zrs5532/mri_demo/references/ft231x-breakout-v11/5vPin.PNG

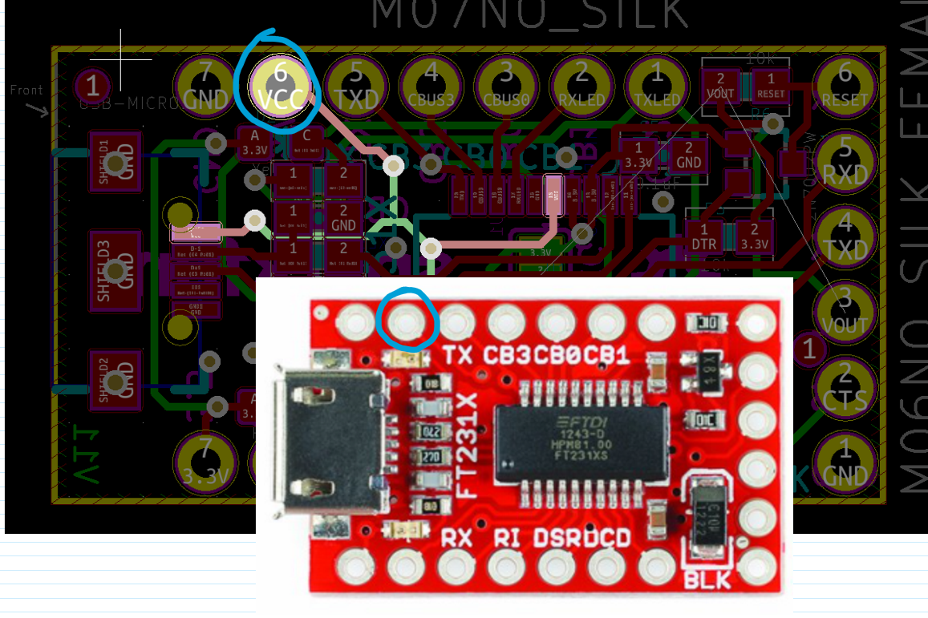
references/ft231x-breakout-v11/5vPin.PNG
