zrs5532/mri_demo/SensorDemoReport.docx

Lou Auto Robotics Research Institute:

Skin Sensor Demo

Daniel Nguyen

MRI Project

April 2021

# Appendix

Appendix A Introduction & Objectives
Appendix B Major Activities
  Appendix B.1 Hardware
  Appendix B.2 Software
Appendix C Conclusion

# Introduction & Objectives

The development of tactile robot skin is crucial for the next generation of robots to interact among human-centered environments. At the Louisville Automation & Robotics Research Institute (LARRI) under the MRI Project, researched have developed electronic skin using multiple sensors and components. The goal of the Demo Sensor Project is to provide a functional demonstration board to show and test the capability of the pickup and place machine, developed by Danming’s group (MRI Project).

The board can be used in two ways, with an off-the-shelf strain gauge sensor or with a strain gauge printed by the Optomec aerosol ink jet printer. The skin can sense changes in pressure using a lever hinge system and measuring a strain gauge using the Wheatstone half-bridge. The main disadvantage of this system is the narrow output range; thus, the output must be amplified adding overall noise.

# Major Activities

### Hardware

Measuring the resistive sensor uses a system including the Wheatstone half-bridge, an instrument amplifier (in-amp), and an analog-digital-convertor (ADC). Figure 1 illustrates an example of the Wheatstone half-bridge.

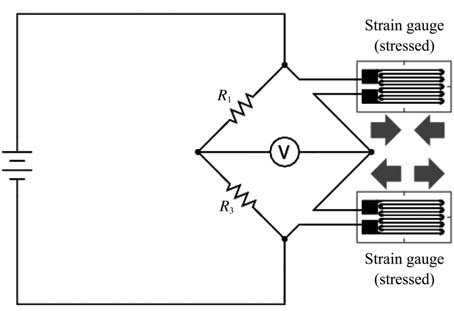
[picture p2: figure]
Wheatstone half-bridge circuit | Download Scientific Diagram

Figure 1: Wheatstone Bridge

The strain gauge device varies in resistance depending on the amount of strain. In the circuit for the Demo Sensor, the resistance with no strain on the device approximately 150 ohms. The strain gauges are put in opposite orientations so when the lever is pushed, one strain gauge gains resistance while the other decreases in resistance. The voltage between the two are inputted into the ADC which shows if the sensor is being pressed.

The material of the strain gauge is a fundamental parameter to the system. It is expressed mathematically as the gauge factor (GF). “Gauge factor is defined as the ratio of fractional change in electrical resistance to the fractional change in length (strain):” (NI Strain Gauge Measurement – A Tutorial)

, GF=(∆R/R)/(∆L/L)=(∆R/R)/ε#(1)

For the Skin Sensor Demo, a GF of 1 is used and a strain (ε) of 500*10^(-6) . After calculations, a ∆R is approximately +/- 0.075 ohms. This can be used in the next calculation to show the how accurate the DAC and ADC must be discussed later.

Figure 2 is a reference of the instrument amplifier.

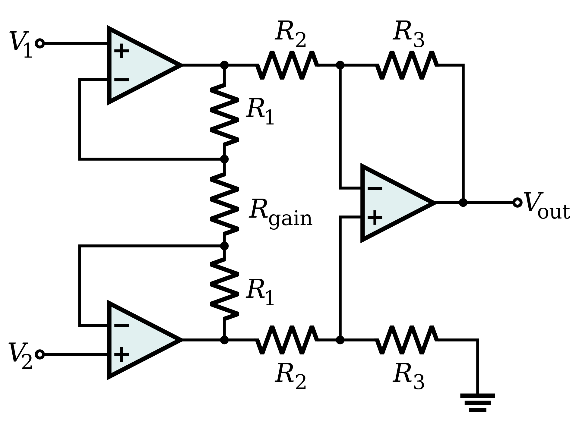
[picture p3: figure]
Instrumentation amplifier - Wikipedia

Figure 2: Instrument Amplifier

The base equation for an instrument amplifier is:

, V_(out) =Gain*(V_1 -V_2 ) + V_(ref) #(2)

Through calibration in the software and the DAC, V_1 is set to a constant value within a small range very close to V_2 . V_2 is connected to the sensor. Thus, any changes in the resistor results in a change in voltage in V_2 being amplified to V_(out) . The instrument amplifier is referenced to 1.5 volts. Using equation 2 calculates that a gain of approximately 2500 best fits the system. Gain is set to a high value because the resistance change of the sensor is small. Under brief testing, a gain of 200 is found to work the best.

Figure 3 shows a block diagram of the circuit.

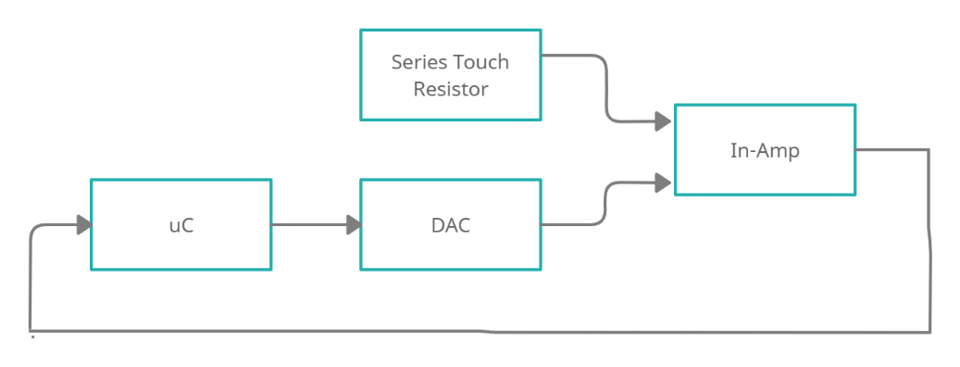
[picture p4: figure]

Figure 3: Block Diagram

As shown in figure 3, the voltage difference measured in the in-amp is the key in measuring the resistance change. The analog-to-digital converter (ADC) of the micro controller and the DAC are 12 bits. The two components are also referenced to 3 volts – GND because of its convenience. The REF19xx series chip is used to reference the voltage is a lower Vref is preferred.

The current design uses a dsPIC33EP32GP502 micro controller, the LTC1659 DAC, and the INA333 instrument amplifier. These components were picked based on how they complement each other as well as the accuracy. Another reason these components were picked is because of the SOIC package. Keep in mind the parts are placed on the PCB with spaced with a certain distance so the Pick-And-Place machine can assemble it with little issues. Because the project is also meant to test this machine, a MSOP8 packaged device is also placed on the board.

The current Micro-Controller Unit (MCU) is used because of its many features such as serial communication busses, flash memory size, and speed. The firmware only uses 6% of the micro’s data bytes and 30% of the micro’s program words.

The accuracy of the ADC and DAC are crucial for this board. The change min and max voltage that is inputted into the ADC is approximately 1.125mV. The step size for a 12-bit ADC and DAC referenced to 3 volts is approximately 0.7324mV. With a gain calculated previously, a 12-bit ADC and DAC are accurate enough for this application.

The LTC1659 DAC is used specifically because it has the same resolution as the micro controller. Because of this, no conversion is needed when sending adjusting the DAC after reading values from the 12-bit ADC of the micro controller during calibration. Figure 4 illustrates the internal structure of the DAC.

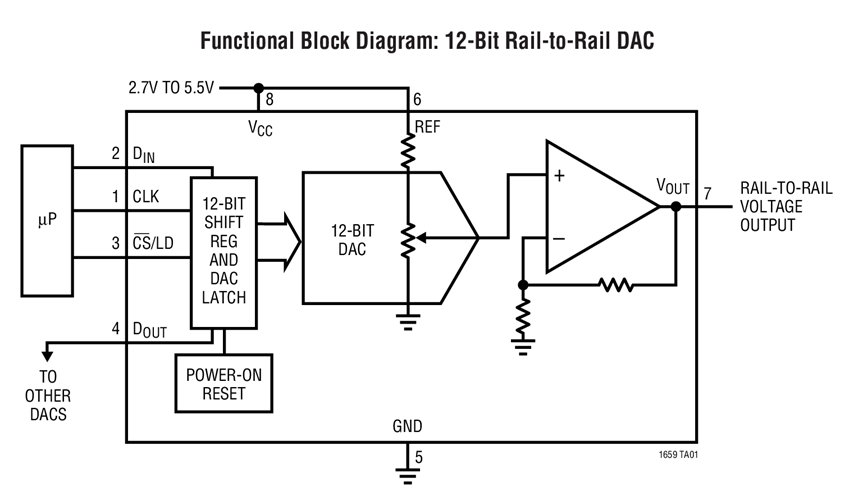
[picture p5: figure]
Functional Block Diagram: 12-Bit Rail-to-Rail DAC

Figure 4: LTC1659 Internal Structure

Because the resistance change of the touch resistor has a very small range, this paired with a less accurate in-amp did not work. For the first prototype, the In-Amp picked is the INA333. It is a rail-to-rail instrument amplifier and is rather accurate. Figure 5 illustrates the internal structure of the INA333.

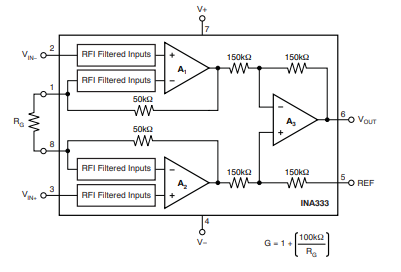
[picture p6: figure]

Figure 5: INA333 Internal Structure

Another small board is designed for the MCU to communicate with the computer. This includes the FT231X Breakout UART to USB. The programming board also allows for the PICkit 3 to connect to the main board.

The software used to design the schematic and PCB is KiCad 64bit for Windows OS version 5.1.9 because of its user-friendly interface and the simplicity of the project.

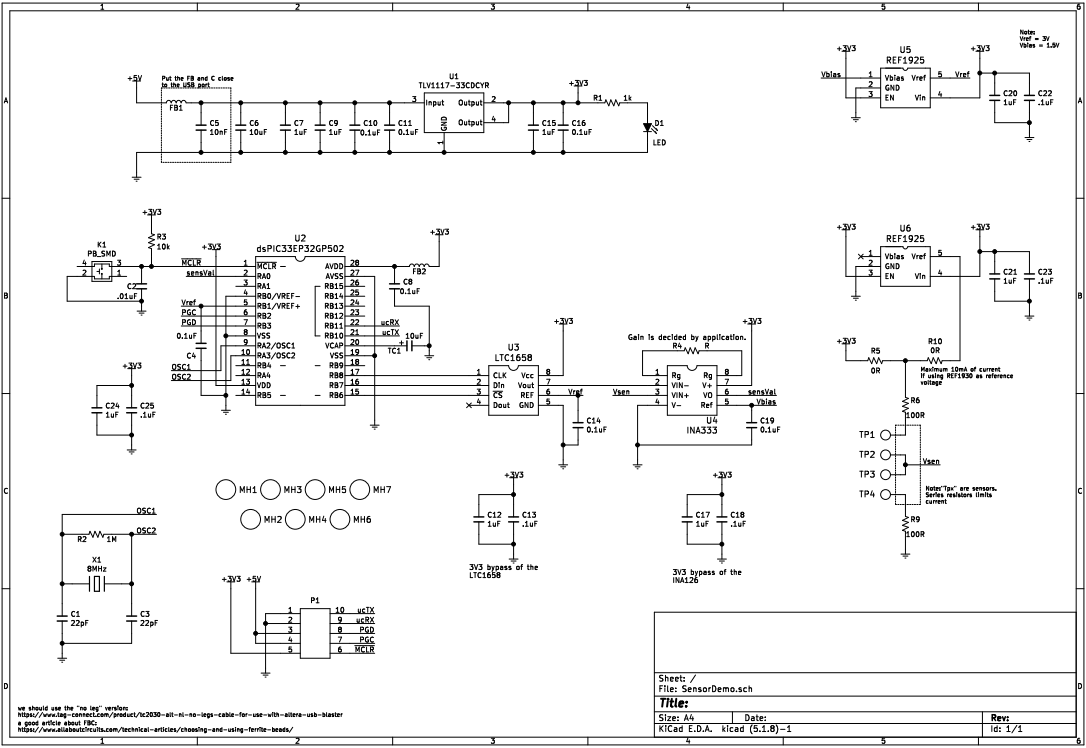
[picture p7: figure]

Figure 6: Schematic of Sensor Demo Board

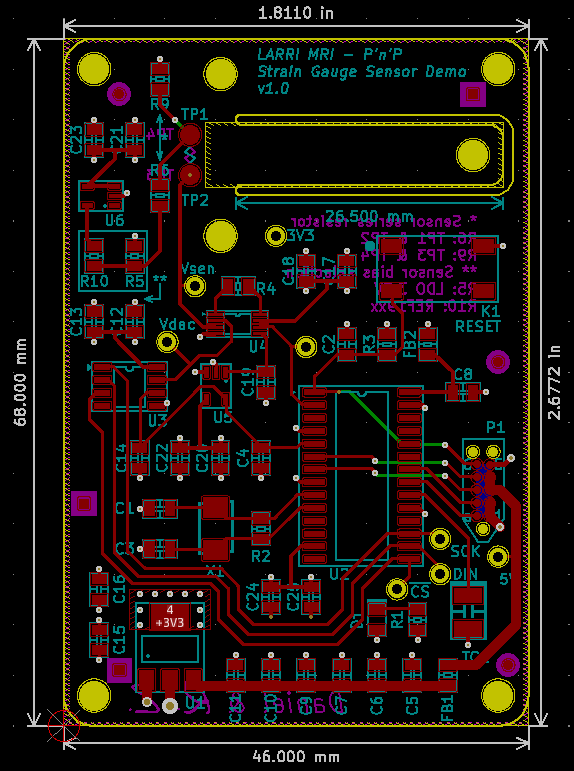
[picture p8: figure]

Figure 7: PCB Design of Sensor Demo Board

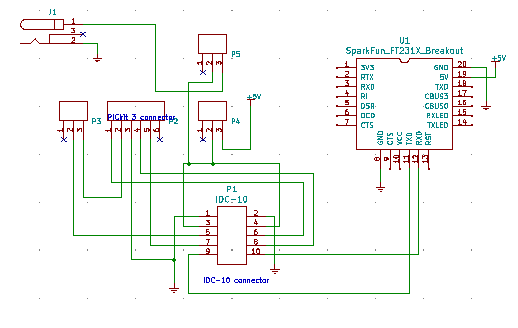
[picture p9: figure]

Figure 8: Schematic Design of Programming Board

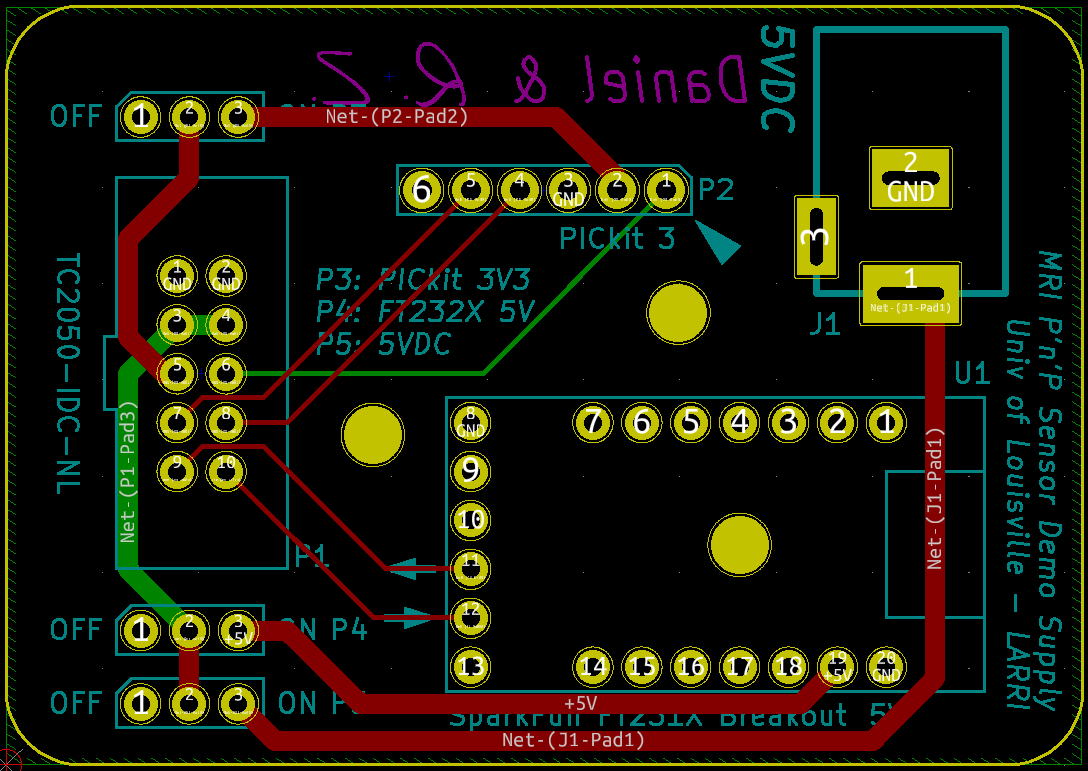
[picture p10: figure]

Figure 9: PCB Design of Programming Board

### Software

Two communication busses are used in the MCU. Those are SPI and UART. The MCU communicates with the DAC through the SPI Bus, and with a computer through the UART communication bus. At boot-up of the PCB, there is a delay for the voltages and board to settle. This is because if the strain gauge sensor is in an off position, the calibration will calibrate to the position that the sensor is in. The ADC reading needs to be stable for the calibration to be most accurate. After this, the software calibrates for the first time.

The software constantly checks the UART Receive register. If it receives a certain keystroke, the software will either recalibrate, stop reading the sensor value, or continue reading the sensor value. A snippet of the code is shown below:

cmd = UART1_RX_NB();

switch(cmd) {

case '1': //Calibrates & reads sensor

runCalibrate = true;

calibrate();

dacIncrement = 200;

runSensor = true;

break;

case '2': //Continue sensor reading

runSensor = true;

break;

case '3': //Stop sensor reading

runSensor = false;

break;

}

The calibration algorithm went through multiple test phases. During the first prototype, a step algorithm was put in place. This will increase or decrease the value the DAC outputs by a small margin to match the idle voltage of the touch resistor. Because the resolution of the ADC and DAC are quite large, the step algorithm was considered too slow and the implementation of a PID controller was tested.

The PID controller was not as fast in practice as in theory because the referenced voltage of the ADC is too small. As mentioned earlier, all the components are referenced from 3 Volts to Ground. If the DAC is too large or small, the ADC reading will read the output as either 0 or the max resolution, 4095 for a 12-bit ADC.

The final algorithm put in place is like a Bang controller. Initially, the DAC will swing a large value until it crosses the setpoint range. Once it crosses the setpoint range, the constant value that the DAC swings is decreased by 50% until it crosses the setpoint again. Through testing, this algorithm has been proven too be significantly faster. A snippet of the code structure is shown below:

while (runCalibrate) {

ADC1Val(); //Updates sensVal (ADC reading)

//if the sensor reading is above/below setpoint, change DAC output

if(sensVal <= lowBound) {

dacVal -= dacIncrement;

flag = 0; //DAC IS BELOW ADC READING

} else if (sensVal >= upperBound) {

dacVal += dacIncrement;

flag = 1; //DAC IS ABOVE ADC READING

}

SPI_transfer16(dacVal);

ADC1Val();

//Checks if ADC reading is within range

if((sensVal >= lowBound) && (sensVal <= upperBound)) {

runCalibrate = false; // BREAK WHILE LOOP

} else if (dacIncrement == 0) {

dacIncrement += 1;

}

//Checks if DAC crossed the setpoint range. If so, decrease the increment.

if((sensVal <= lowBound) && (flag == 1)) {

dacIncrement = (uint16_t)(dacIncrement / 2);

} else if ((sensVal >= upperBound) && (flag == 0)) {

dacIncrement = (uint16_t)(dacIncrement / 2);

}

ADC1Val();

printf("Calibrating... %u\n\r", sensVal);

}

}

# Conclusion

This project serves multiple purposes such as a tactile sensor that can be used as electronic robotic skin and a board used to test the Pick-And-Place machine at the LARRI lab. The PCB is designed with the components spaced out to test the accuracy of the new machine. This Sensor Board Demo also contributes to other areas in the MRI Project such as the Octo-Can through the software such as the calibration algorithm.

Works Cited

National Instruments Corporation. Strain Gauge Measurement – a Tutorial What Is Strain? 1998. http://elektron.pol.lublin.pl/elekp/ap_notes/NI_AN078_Strain_Gauge_Meas.pdf
