zrs5532/mri_demo/circuit_board/BOM.xlsx

Component | Description | Link | Quantity
C1, C3 | 22pF | https://www.mouser.com/ProductDetail/KEMET/C0805C220K3HACTU?qs=W0yvOO0ixfH4YTEs6bNX1Q%3D%3D | 100
C2, C5, C6 | 0.01uF | https://www.mouser.com/ProductDetail/AVX/08051C103KAT2A?qs=KWx4lwXkSG0FvSLLLRI%252BHw%3D%3D | 100
C4, C8, C10, C11, C13, C14, C16, C18, C19, C22, C23, C25 | 0.1uF | https://www.mouser.com/ProductDetail/AVX/08055C104KAT2A | 100
C7, C9, C12, C15, C17, C20, C21, C24 | 1uF | https://www.mouser.com/ProductDetail/Samsung-Electro-Mechanics/CL21B105KOFNNNG | 100
FB1, FB2 | 12.3071 nano Ohm | https://www.mouser.com/ProductDetail/Fair-Rite/2508051027Y1?qs=paL1wOLBYNd1w0Ok9jKq0w%3D%3D | 100
K1 | Push Button | https://www.mouser.com/ProductDetail/E-Switch/LL3301NF065QG/?qs=QtyuwXswaQiWhwgY68YTTw%3D%3D | 25
R1 | 1k Ohm | https://www.mouser.com/ProductDetail/Vishay-Dale/CRCW08051K00FKEAC | 100
R2 | 1M Ohm | https://www.mouser.com/ProductDetail/Vishay-Dale/CRCW08051M00FKEAC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 | 100
R3 | 10k Ohm | https://www.mouser.com/ProductDetail/Bourns/CR0805-FX-1003ELF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 | 100
R6, R9 | 100 Ohm | https://www.mouser.com/ProductDetail/Vishay-Dale/CRCW0805100RFKEAC | 100
TC1 | 10uF | https://www.mouser.com/ProductDetail/AVX/TAJA106K010RNJV?qs=q%252BHV0zBR8MhA8vzi7uQCHA%3D%3D | 20
U1 | LDO - TLV1117-33CDCYR | https://www.mouser.com/ProductDetail/STMicroelectronics/LDL1117S33R?qs=AQlKX63v8Rt9Bf6AWSrbFg%3D%3D | 20
U2 | dsPIC33EP32GP502 | https://www.mouser.com/ProductDetail/Microchip-Technology/dsPIC33EP32GP502-E-SO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 | 5
U3 | DAC - LTC1659 | https://www.mouser.com/ProductDetail/Analog-Devices/LTC1659CS8PBF?qs=hVkxg5c3xu8qJBo8OQTZhA%3D%3D | 5
 | LTC 1655L | https://www.mouser.com/ProductDetail/Analog-Devices/LTC1655LCS8PBF?qs=hVkxg5c3xu8u%2FxCpkCR9Ow%3D%3D | 3
 | LED | https://www.mouser.com/ProductDetail/Kingbright/APT2012SRCPRV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 | 10
 | 0R | https://www.mouser.com/ProductDetail/Yageo/RC0805JR-070RL | 100
 | IDC | https://www.mouser.com/ProductDetail/Wurth-Elektronik/61201021621 | 5
 | uart bridge | https://www.mouser.com/ProductDetail/SparkFun/BOB-13263?qs=wwacUt%252BV97sxFBQnsYRtRA%3D%3D | 3
 | tag-cable | https://www.tag-connect.com/product/tc2050-idc-nl-10-pin-no-legs-cable-with-ribbon-connector | 1
stunts | SOIC8 | https://www.mouser.com/ProductDetail/STMicroelectronics/LM358DT | 10
 | MSOP8 | https://www.mouser.com/ProductDetail/NJR/NJM2904CARB1-TE1 | 10
 | SOIC28 | https://www.mouser.com/ProductDetail/Microchip-Technology/PIC16F57-I-SO?qs=Sez7gRs8XSVGQsbqhsgs1Q%3D%3D | 10
 | SOT23-5 | https://www.mouser.com/ProductDetail/Microchip-Technology-Micrel/MIC5504-33YM5-TR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 | 10
 | SOT223 | https://www.mouser.com/ProductDetail/Nexperia/PMT560ENEAX?qs=gH1BdSMZm8VarNhHxchsUg%3D%3D | 10
