zrs5532/mri_demo/circuit_board/SensorDemo/SensorDemo.kicad_pcb

## KiCad design circuit_board/SensorDemo/SensorDemo.kicad_pcb (2021-08-11)

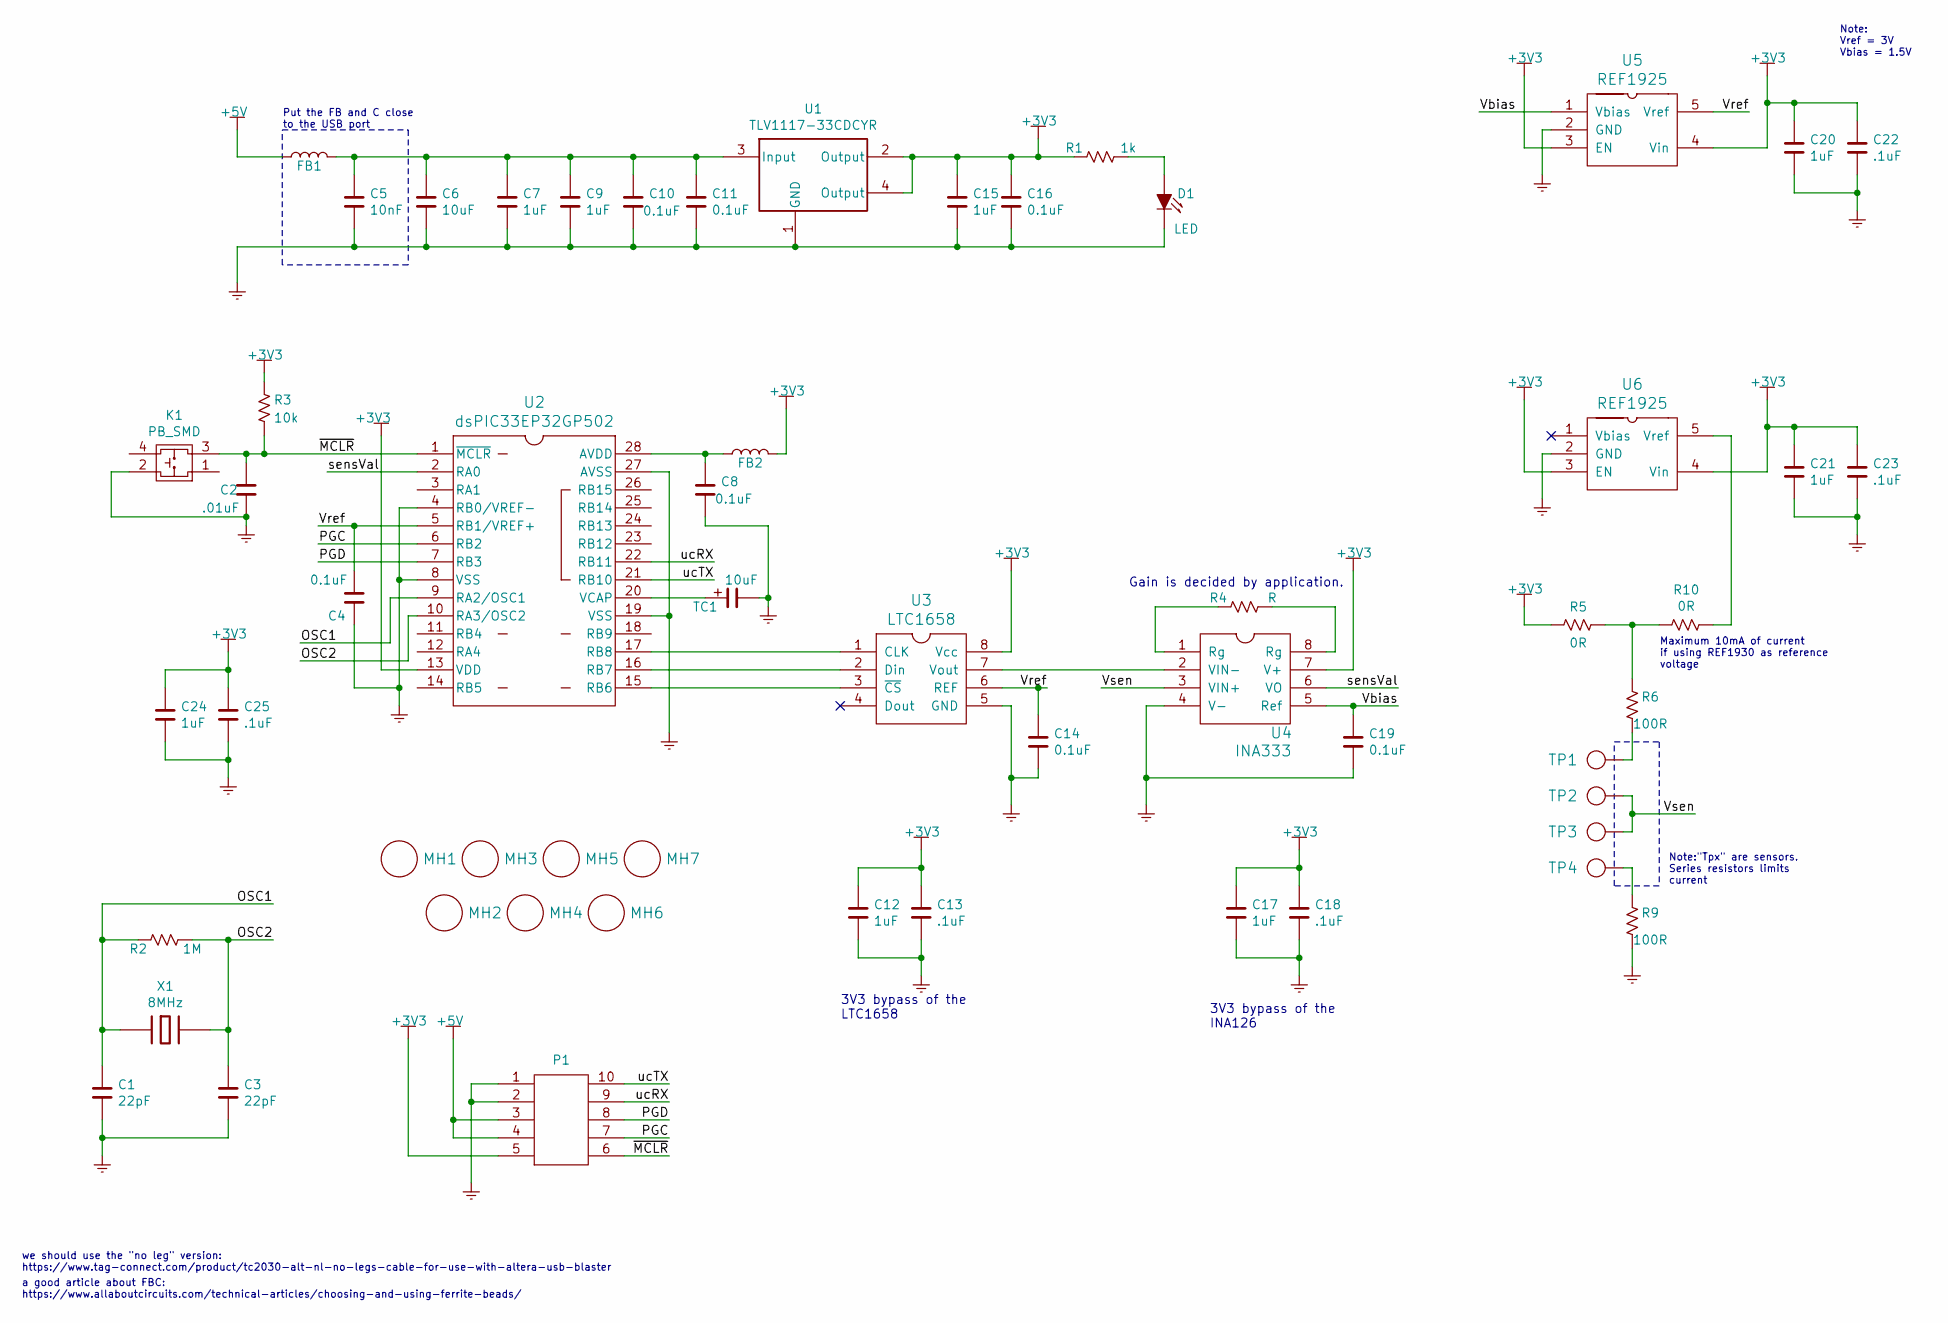
[picture p11: schematic SensorDemo.sch]

Parts:
C1, C3: 22pF; C0805
C2: .01uF; C0805
C4, C8, C10, C11, C14, C16, C19: 0.1uF; C0805
C5: 10nF; C0805
C6: 10uF; C0805
C7, C9, C12, C15, C17, C20, C21, C24: 1uF; C0805
C13, C18, C22, C23, C25: .1uF; C0805
D1: LED; LED0805
FB1, FB2: 12.3071 nano ohm; R0805
K1: PB_SMD; Key_SMD
MH1, MH2, MH3, MH4, MH5, MH6, MH7: MH; MH_3MM
P1: TC2050_IDC_NL; TC2050
R1: 1k; R0805
R2: 1M; R0805
R3: 10k; R0805
R4: R; R0805
R5, R10: 0R; R0805
R6, R9: 100R; R0805
TC1: 10uF; C1210
TP1, TP2, TP3, TP4: TP; TP_SMD_2MM
U1: TLV1117-33CDCYR; SOT-223
U2: dsPIC33EP32GP502; SOIC-28
U3: LTC1658; SOIC-8
U4: INA333; MSOP-8
U5, U6: REF1925; SOT-23-5
X1: 8MHz; CRYSTAL_ABM3-8.000MHz-D2Y-T

Connections:
+3V3: C12.1, C13.1, C15.1, C16.1, C17.1, C18.1, C20.1, C21.1, C22.1, C23.1, C24.1, C25.1, FB2.2, P1.5, R1.1, R3.1, R5.1, U1.2 (Output), U1.4 (Output), U2.13 (VDD), U3.8 (Vcc), U4.7 (V+), U5.3 (EN), U5.4 (Vin), U6.3 (EN), U6.4 (Vin); also elsewhere on the board
+5V: FB1.1, P1.3, P1.4; also elsewhere on the board
/OSC1: C1.1, R2.1, U2.9 (RA2/OSC1), X1.1
/OSC2: C3.1, R2.2, U2.10 (RA3/OSC2), X1.2
/PGC: P1.7, U2.6 (RB2)
/PGD: P1.8, U2.7 (RB3)
/Vbias: C19.1, U4.5 (Ref), U5.1 (Vbias)
/Vref: C4.1, C14.1, U2.5 (RB1/VREF+), U3.6 (REF), U5.5 (Vref)
/Vsen: TP2.1, TP3.1, U4.3 (VIN+); also elsewhere on the board
/sensVal: U2.2 (RA0), U4.6 (VO); also elsewhere on the board
/ucRX: P1.9, U2.22 (RB11)
/ucTX: P1.10, U2.21 (RB10)
/~MCLR: C2.1, K1.3, P1.6, R3.2, U2.1 (~MCLR)
GND: C1.2, C2.2, C3.2, C4.2, C5.2, C6.2, C7.2, C8.2, C9.2, C10.2, C11.2, C12.2, C13.2, C14.2, C15.2, C16.2, C17.2, C18.2, C19.2, C20.2, C21.2, C22.2, C23.2, C24.2, C25.2, D1.2 (K), K1.2, P1.1, P1.2, R9.2, TC1.2, U1.1 (GND), U2.4 (RB0/VREF-), U2.8 (VSS), U2.19 (VSS), U2.27 (AVSS), U3.5 (GND), U4.4 (V-), U5.2 (GND), U6.2 (GND)
unnamed: C8.1, FB2.1, U2.28 (AVDD)
unnamed: C5.1, C6.1, C7.1, C9.1, C10.1, C11.1, FB1.2, U1.3 (Input)
unnamed: D1.1 (A), R1.2
unnamed: R4.1, U4.1 (Rg)
unnamed: R4.2, U4.8 (Rg)
unnamed: R6.2, TP1.1
unnamed: R9.1, TP4.1
unnamed: R5.2, R6.1, R10.1
unnamed: R10.2, U6.5 (Vref)
unnamed: TC1.1, U2.20 (VCAP)
unnamed: U2.15 (RB6), U3.3 (~CS)
unnamed 25: U2.16 (RB7), U3.2 (Din); also elsewhere on the board
unnamed 26: U2.17 (RB8), U3.1 (CLK); also elsewhere on the board
unnamed 27: U3.7 (Vout), U4.2 (VIN-); also elsewhere on the board

Notes on the sheet:
Note: Vref = 3V Vbias = 1.5V
Put the FB and C close to the USB port
a good article about FBC: https://www.allaboutcircuits.com/technical-articles/choosing-and-using-ferrite-beads/
Gain is decided by application.
3V3 bypass of the LTC1658
3V3 bypass of the INA126
Maximum 10mA of current if using REF1930 as reference voltage
Note:"Tpx" are sensors. Series resistors limits current
we should use the "no leg" version: https://www.tag-connect.com/product/tc2030-alt-nl-no-legs-cable-for-use-with-altera-usb-blaster

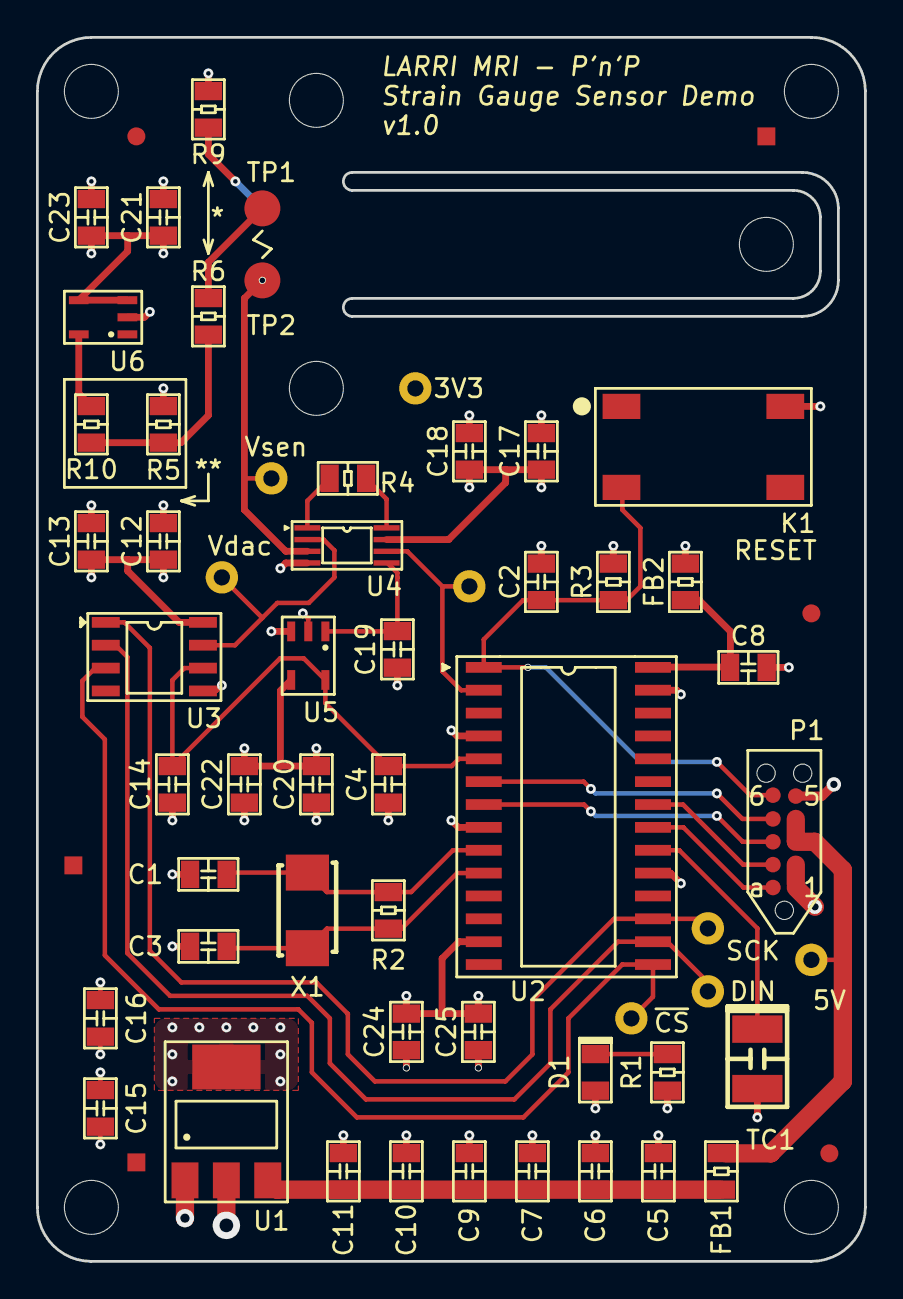
[picture p12: board SensorDemo.kicad_pcb from above]

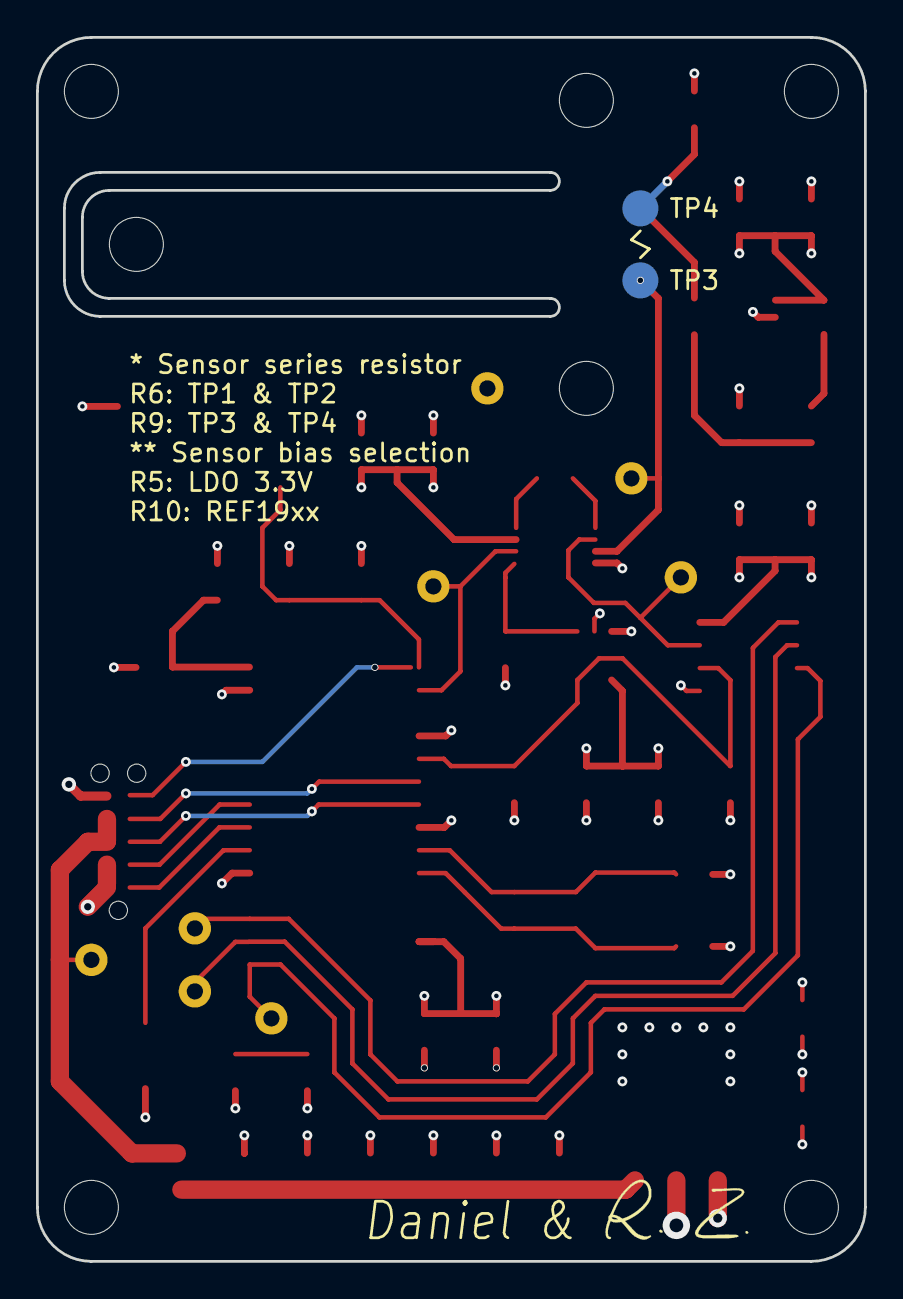
[picture p13: board SensorDemo.kicad_pcb from below]

Board: 4 copper layers, 46.0 x 68.0 mm, 70 parts (2 on the bottom side), 28 nets.

Other parts of the board:
3V3, 5V: TP_TH
DIN: TP_TH
FD: Val**; FD_1MM_CR
FD#2, FD#3, FD#5: Val**; FD_1MM_SQ
FD#4, FD#6: Val**; FD_1MM_CR
SCK: TP_TH
Vdac: TP_TH
Vsen: TP_TH
sensVal: TP_TH

Their connections:
+3V3: 3V3.1; also elsewhere on the board
+5V: 5V.1; also elsewhere on the board
/Vsen: Vsen.1; also elsewhere on the board
/sensVal: sensVal.1; also elsewhere on the board
unnamed 25: DIN.1; also elsewhere on the board
unnamed 26: SCK.1; also elsewhere on the board
unnamed 27: Vdac.1; also elsewhere on the board
