zrs5532/mri_demo/circuit_board/ProgramBoard/ProgramBoard.kicad_pcb

## KiCad design circuit_board/ProgramBoard/ProgramBoard.kicad_pcb (2021-03-16)

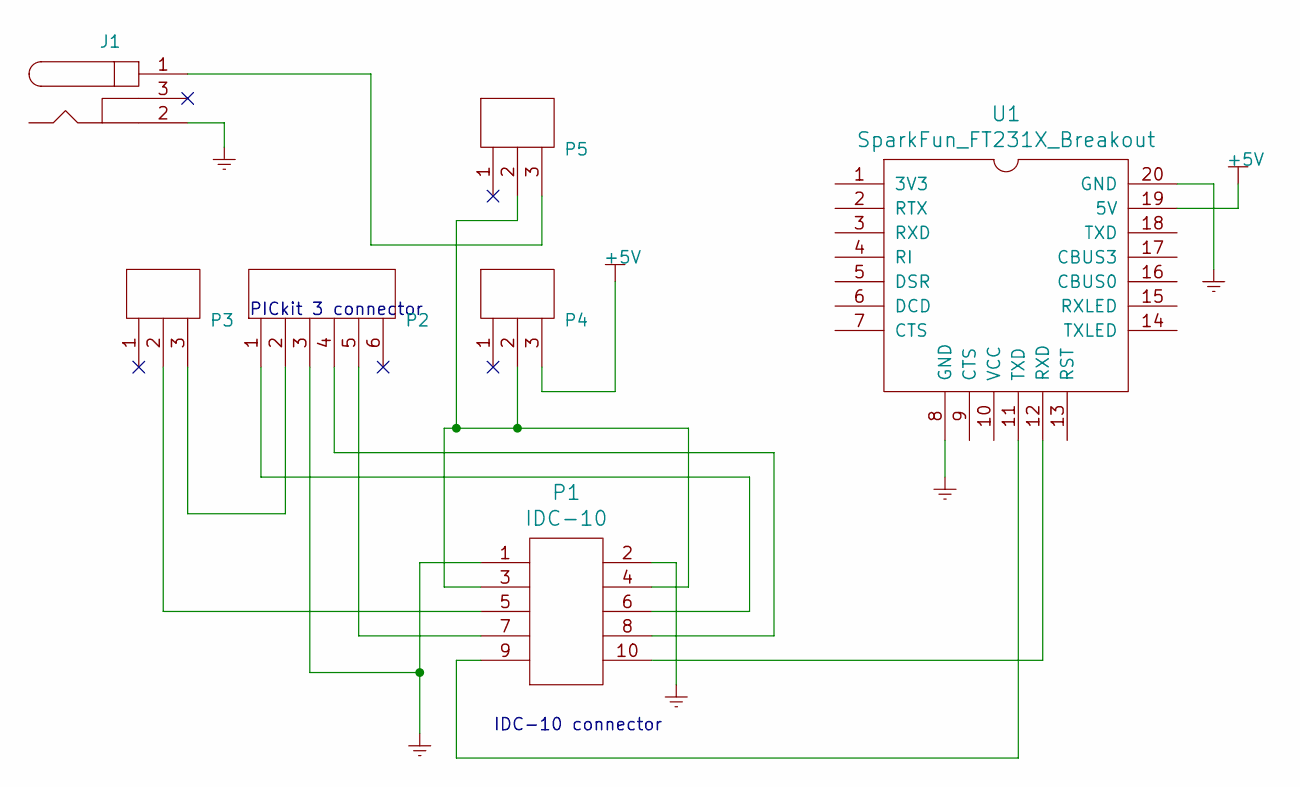
[picture p14: schematic ProgramBoard.sch]

Parts:
J1: BARREL_JACK
P1: IDC-10; IDC_10
P2: HEADER_6
P3, P4, P5: HEADER_3
U1: SparkFun_FT231X_Breakout

Connections:
+5V: P4.3, U1.19 (5V)
GND: J1.2, P1.1, P1.2, P2.3, U1.8 (GND), U1.20 (GND)
unnamed: J1.1, P5.3
unnamed: P1.3, P1.4, P4.2, P5.2
unnamed: P1.5, P3.2
unnamed: P1.6, P2.1
unnamed: P1.7, P2.5
unnamed: P1.8, P2.4
unnamed: P1.9, U1.11 (TXD)
unnamed: P1.10, U1.12 (RXD)
unnamed: P2.2, P3.3

Notes on the sheet:
PICkit 3 connector
IDC-10 connector

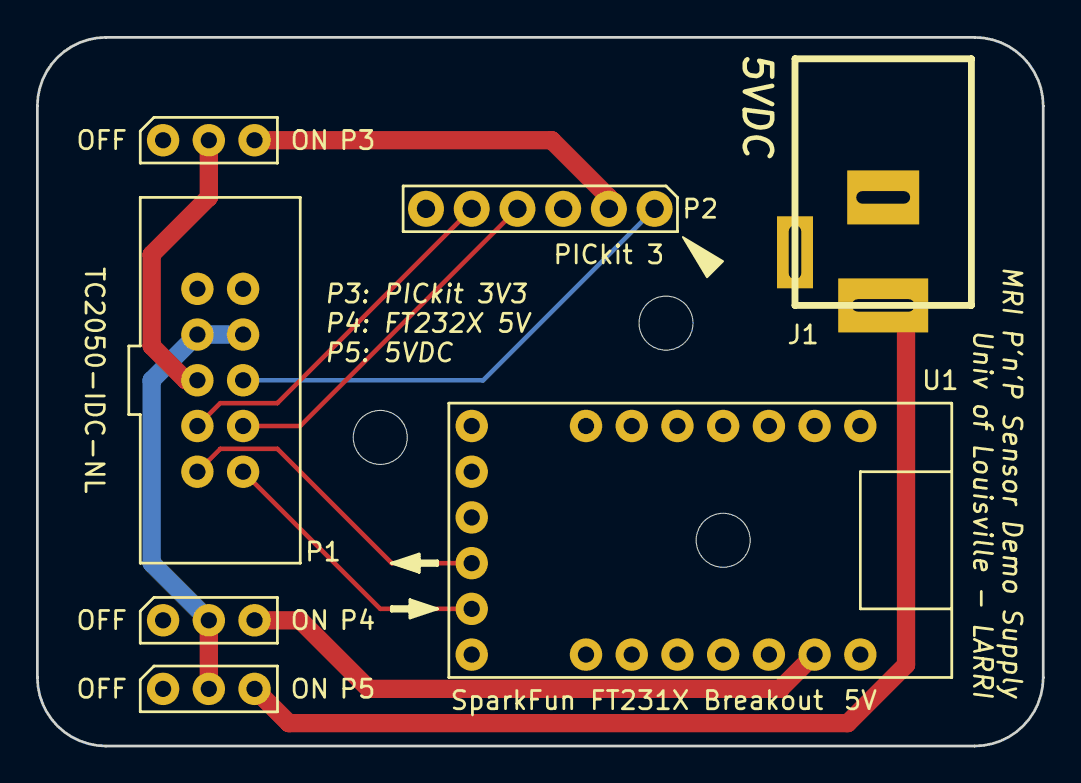
[picture p15: board ProgramBoard.kicad_pcb from above]

Board: 2 copper layers, 55.9 x 39.4 mm, 10 parts (0 on the bottom side), 11 nets.

Other parts of the board:
MH3, MH3#2, MH3#3: MH; MH_3MM
