zrs5532/mri_demo/references/ft231x-breakout-v11/ft231x-breakout-v11.brd

## EAGLE design references/ft231x-breakout-v11/ft231x-breakout-v11.brd (2021-02-16)

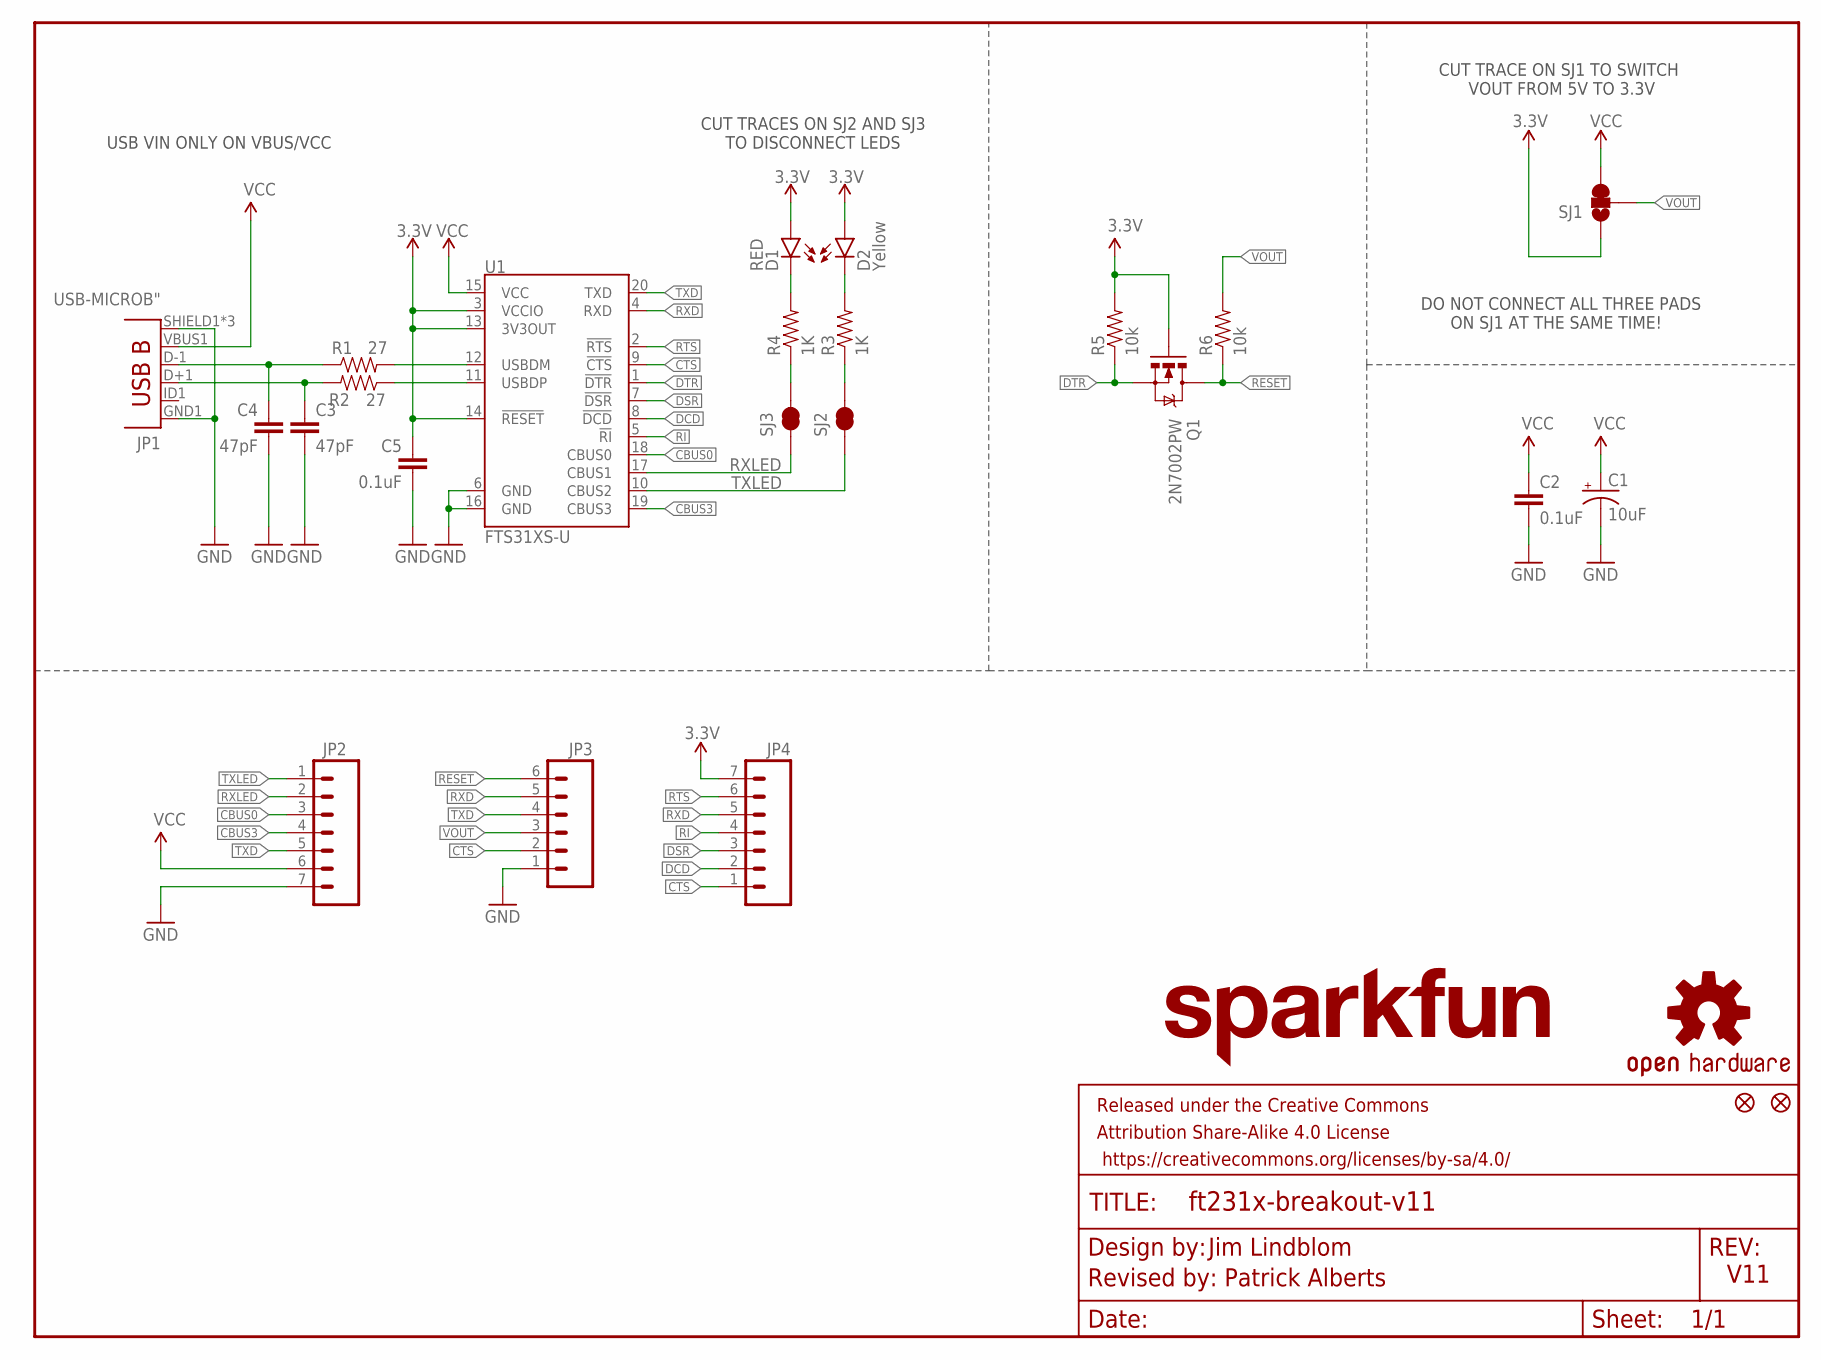
[picture p16: schematic ft231x-breakout-v11.sch]

Parts:
C1: 10uF; EIA3216
C2, C5: 0.1uF; 0603-CAP
C3, C4: 47pF; 0603-CAP
D1: RED; LED-0603
D2: Yellow; LED-0603
FRAME1: FRAME-LETTER; CREATIVE_COMMONS
JP1: USB-MICROB"; USB-B-MICRO-SMD_V03
JP2, JP4: M07NO_SILK; 1X07_NO_SILK
JP3: M06NO_SILK_FEMALE_PTH; 1X06_NO_SILK
JP5, JP6: FIDUCIAL1X2; FIDUCIAL-1X2
LOGO1: SFE_LOGO_NAME.1_INCH; SFE_LOGO_NAME_.1
Q1: 2N7002PW; SOT323
R1, R2: 27; 0603-RES
R3, R4: 1K; 0603-RES
R5, R6: 10k; 0603-RES@1
SJ1: SOLDERJUMPER_2WAYS; SJ_3
SJ2: TXLED; SJ_2S-TRACE
SJ3: RXLED; PAD-JUMPER-2-NC_BY_TRACE_YES_SILK
U1: FTS31XS-U; SSOP20_L
U$1: OSHW-LOGOS; OSHW-LOGO-S

Connections:
3.3V: C5.1, D1.A, D2.A, JP4.7, Q1.1 (G), R5.2, SJ1.1, U1.3 (VCCIO), U1.13 (3V3OUT), U1.14 (!RESET)
CBUS0: JP2.3, U1.18 (CBUS0)
CBUS3: JP2.4, U1.19 (CBUS3)
CTS: JP3.2, JP4.1, U1.9 (!CTS)
DCD: JP4.2, U1.8 (!DCD)
DSR: JP4.3, U1.7 (!DSR)
DTR: Q1.2 (S), R5.1, U1.1 (!DTR)
GND: C1.C (-), C2.2, C3.2, C4.2, C5.2, JP1.GND1 (GND), JP1.SHIELD1 (SHIELD), JP1.SHIELD2 (SHIELD), JP1.SHIELD3 (SHIELD), JP2.7, JP3.1, U1.6 (GND), U1.16 (GND)
unnamed: R1.2, U1.12 (USBDM)
unnamed: R2.1, U1.11 (USBDP)
unnamed: C3.1, JP1.D+1 (D+), R2.2
unnamed: C4.1, JP1.D-1 (D-), R1.1
unnamed: D2.C, R3.2
unnamed: D1.C, R4.2
unnamed: R3.1, SJ2.2
unnamed: R4.1, SJ3.2
RESET: JP3.6, Q1.3 (D), R6.1
RI: JP4.4, U1.5 (!RI)
RTS: JP4.6, U1.2 (!RTS)
RXD: JP3.5, JP4.5, U1.4 (RXD)
RXLED: JP2.2, SJ3.1, U1.17 (CBUS1)
TXD: JP2.5, JP3.4, U1.20 (TXD)
TXLED: JP2.1, SJ2.1, U1.10 (CBUS2)
VCC: C1.A (+), C2.1, JP1.VBUS1 (VBUS), JP2.6, SJ1.3, U1.15 (VCC)
VOUT: JP3.3, R6.2, SJ1.2

Notes on the sheet:
V11
Jim Lindblom
Revised by: Patrick Alberts
USB VIN ONLY ON VBUS/VCC
CUT TRACES ON SJ2 AND SJ3 TO DISCONNECT LEDS
CUT TRACE ON SJ1 TO SWITCH VOUT FROM 5V TO 3.3V
DO NOT CONNECT ALL THREE PADS ON SJ1 AT THE SAME TIME!

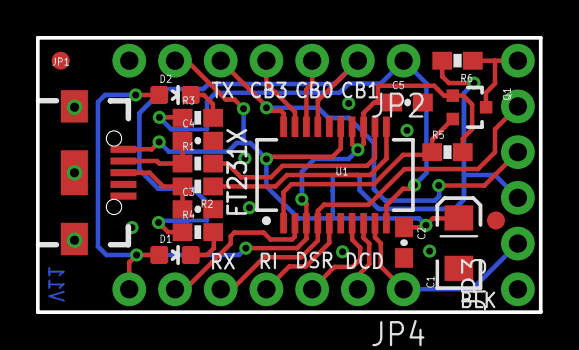
[picture p17: board ft231x-breakout-v11.brd from above]

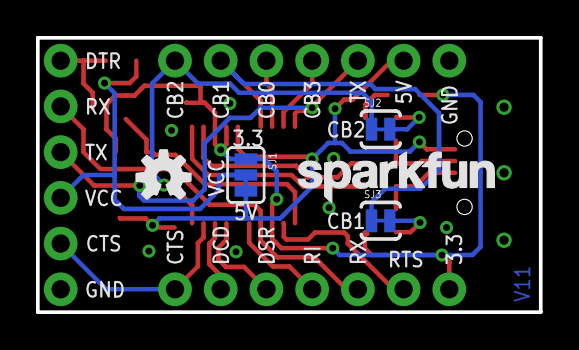
[picture p18: board ft231x-breakout-v11.brd from below]

Board: 2 copper layers, 27.9 x 15.2 mm, 27 parts (5 on the bottom side), 25 nets.
