zrs5532/mri_demo/firmware/SensorDemo.X/mcc_generated_files/pin_manager.h

/**
  PIN MANAGER Generated Driver File

  @Company:
    Microchip Technology Inc.

  @File Name:
    pin_manager.h

  @Summary:
    This is the generated manager file for the PIC24 / dsPIC33 / PIC32MM MCUs device.  This manager
    configures the pins direction, initial state, analog setting.
    The peripheral pin select, PPS, configuration is also handled by this manager.

  @Description:
    This source file provides implementations for PIN MANAGER.
    Generation Information :
        Product Revision  :  PIC24 / dsPIC33 / PIC32MM MCUs - 1.170.0
        Device            :  dsPIC33EP32GP502
    The generated drivers are tested against the following:
        Compiler          :  XC16 v1.61
        MPLAB 	          :  MPLAB X v5.45
*/

/*
    (c) 2020 Microchip Technology Inc. and its subsidiaries. You may use this
    software and any derivatives exclusively with Microchip products.

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
    IN NO EVENT WILL MICROCHIP BE LIABLE FOR ANY INDIRECT, SPECIAL, PUNITIVE,
    INCIDENTAL OR CONSEQUENTIAL LOSS, DAMAGE, COST OR EXPENSE OF ANY KIND
    WHATSOEVER RELATED TO THE SOFTWARE, HOWEVER CAUSED, EVEN IF MICROCHIP HAS
    BEEN ADVISED OF THE POSSIBILITY OR THE DAMAGES ARE FORESEEABLE. TO THE
    FULLEST EXTENT ALLOWED BY LAW, MICROCHIP'S TOTAL LIABILITY ON ALL CLAIMS IN
    ANY WAY RELATED TO THIS SOFTWARE WILL NOT EXCEED THE AMOUNT OF FEES, IF ANY,
    THAT YOU HAVE PAID DIRECTLY TO MICROCHIP FOR THIS SOFTWARE.

    MICROCHIP PROVIDES THIS SOFTWARE CONDITIONALLY UPON YOUR ACCEPTANCE OF THESE
    TERMS.
*/

#ifndef _PIN_MANAGER_H
#define _PIN_MANAGER_H
/**
    Section: Includes
*/
#include <xc.h>

/**
    Section: Device Pin Macros
*/
/**
  @Summary
    Sets the GPIO pin, RA0, high using LATA0.

  @Description
    Sets the GPIO pin, RA0, high using LATA0.

  @Preconditions
    The RA0 must be set to an output.

  @Returns
    None.

  @Param
    None.

  @Example
    <code>
    // Set RA0 high (1)
    channel_AN0_SetHigh();
    </code>

*/
#define channel_AN0_SetHigh()          (_LATA0 = 1)
/**
  @Summary
    Sets the GPIO pin, RA0, low using LATA0.

  @Description
    Sets the GPIO pin, RA0, low using LATA0.

  @Preconditions
    The RA0 must be set to an output.

  @Returns
    None.

  @Param
    None.

  @Example
    <code>
    // Set RA0 low (0)
    channel_AN0_SetLow();
    </code>

*/
#define channel_AN0_SetLow()           (_LATA0 = 0)
/**
  @Summary
    Toggles the GPIO pin, RA0, using LATA0.

  @Description
    Toggles the GPIO pin, RA0, using LATA0.

  @Preconditions
    The RA0 must be set to an output.

  @Returns
    None.

  @Param
    None.

  @Example
    <code>
    // Toggle RA0
    channel_AN0_Toggle();
    </code>

*/
#define channel_AN0_Toggle()           (_LATA0 ^= 1)
/**
  @Summary
    Reads the value of the GPIO pin, RA0.

  @Description
    Reads the value of the GPIO pin, RA0.

  @Preconditions
    None.

  @Returns
    None.

  @Param
    None.

  @Example
    <code>
    uint16_t portValue;

    // Read RA0
    postValue = channel_AN0_GetValue();
    </code>

*/
#define channel_AN0_GetValue()         _RA0
/**
  @Summary
    Configures the GPIO pin, RA0, as an input.

  @Description
    Configures the GPIO pin, RA0, as an input.

  @Preconditions
    None.

  @Returns
    None.

  @Param
    None.

  @Example
    <code>
    // Sets the RA0 as an input
    channel_AN0_SetDigitalInput();
    </code>

*/
#define channel_AN0_SetDigitalInput()  (_TRISA0 = 1)
/**
  @Summary
    Configures the GPIO pin, RA0, as an output.

  @Description
    Configures the GPIO pin, RA0, as an output.

  @Preconditions
    None.

  @Returns
    None.

  @Param
    None.

  @Example
    <code>
    // Sets the RA0 as an output
    channel_AN0_SetDigitalOutput();
    </code>

*/
#define channel_AN0_SetDigitalOutput() (_TRISA0 = 0)
/**
  @Summary
    Sets the GPIO pin, RB6, high using LATB6.

  @Description
    Sets the GPIO pin, RB6, high using LATB6.

  @Preconditions
    The RB6 must be set to an output.

  @Returns
    None.

  @Param
    None.

  @Example
    <code>
    // Set RB6 high (1)
    CS1_SetHigh();
    </code>

*/
#define CS1_SetHigh()          (_LATB6 = 1)
/**
  @Summary
    Sets the GPIO pin, RB6, low using LATB6.

  @Description
    Sets the GPIO pin, RB6, low using LATB6.

  @Preconditions
    The RB6 must be set to an output.

  @Returns
    None.

  @Param
    None.

  @Example
    <code>
    // Set RB6 low (0)
    CS1_SetLow();
    </code>

*/
#define CS1_SetLow()           (_LATB6 = 0)
/**
  @Summary
    Toggles the GPIO pin, RB6, using LATB6.

  @Description
    Toggles the GPIO pin, RB6, using LATB6.

  @Preconditions
    The RB6 must be set to an output.

  @Returns
    None.

  @Param
    None.

  @Example
    <code>
    // Toggle RB6
    CS1_Toggle();
    </code>

*/
#define CS1_Toggle()           (_LATB6 ^= 1)
/**
  @Summary
    Reads the value of the GPIO pin, RB6.

  @Description
    Reads the value of the GPIO pin, RB6.

  @Preconditions
    None.

  @Returns
    None.

  @Param
    None.

  @Example
    <code>
    uint16_t portValue;

    // Read RB6
    postValue = CS1_GetValue();
    </code>

*/
#define CS1_GetValue()         _RB6
/**
  @Summary
    Configures the GPIO pin, RB6, as an input.

  @Description
    Configures the GPIO pin, RB6, as an input.

  @Preconditions
    None.

  @Returns
    None.

  @Param
    None.

  @Example
    <code>
    // Sets the RB6 as an input
    CS1_SetDigitalInput();
    </code>

*/
#define CS1_SetDigitalInput()  (_TRISB6 = 1)
/**
  @Summary
    Configures the GPIO pin, RB6, as an output.

  @Description
    Configures the GPIO pin, RB6, as an output.

  @Preconditions
    None.

  @Returns
    None.

  @Param
    None.

  @Example
    <code>
    // Sets the RB6 as an output
    CS1_SetDigitalOutput();
    </code>

*/
#define CS1_SetDigitalOutput() (_TRISB6 = 0)
/**
  @Summary
    Sets the GPIO pin, RB7, high using LATB7.

  @Description
    Sets the GPIO pin, RB7, high using LATB7.

  @Preconditions
    The RB7 must be set to an output.

  @Returns
    None.

  @Param
    None.

  @Example
    <code>
    // Set RB7 high (1)
    SDO2_SetHigh();
    </code>

*/
#define SDO2_SetHigh()          (_LATB7 = 1)
/**
  @Summary
    Sets the GPIO pin, RB7, low using LATB7.

  @Description
    Sets the GPIO pin, RB7, low using LATB7.

  @Preconditions
    The RB7 must be set to an output.

  @Returns
    None.

  @Param
    None.

  @Example
    <code>
    // Set RB7 low (0)
    SDO2_SetLow();
    </code>

*/
#define SDO2_SetLow()           (_LATB7 = 0)
/**
  @Summary
    Toggles the GPIO pin, RB7, using LATB7.

  @Description
    Toggles the GPIO pin, RB7, using LATB7.

  @Preconditions
    The RB7 must be set to an output.

  @Returns
    None.

  @Param
    None.

  @Example
    <code>
    // Toggle RB7
    SDO2_Toggle();
    </code>

*/
#define SDO2_Toggle()           (_LATB7 ^= 1)
/**
  @Summary
    Reads the value of the GPIO pin, RB7.

  @Description
    Reads the value of the GPIO pin, RB7.

  @Preconditions
    None.

  @Returns
    None.

  @Param
    None.

  @Example
    <code>
    uint16_t portValue;

    // Read RB7
    postValue = SDO2_GetValue();
    </code>

*/
#define SDO2_GetValue()         _RB7
/**
  @Summary
    Configures the GPIO pin, RB7, as an input.

  @Description
    Configures the GPIO pin, RB7, as an input.

  @Preconditions
    None.

  @Returns
    None.

  @Param
    None.

  @Example
    <code>
    // Sets the RB7 as an input
    SDO2_SetDigitalInput();
    </code>

*/
#define SDO2_SetDigitalInput()  (_TRISB7 = 1)
/**
  @Summary
    Configures the GPIO pin, RB7, as an output.

  @Description
    Configures the GPIO pin, RB7, as an output.

  @Preconditions
    None.

  @Returns
    None.

  @Param
    None.

  @Example
    <code>
    // Sets the RB7 as an output
    SDO2_SetDigitalOutput();
    </code>

*/
#define SDO2_SetDigitalOutput() (_TRISB7 = 0)
/**
  @Summary
    Sets the GPIO pin, RB8, high using LATB8.

  @Description
    Sets the GPIO pin, RB8, high using LATB8.

  @Preconditions
    The RB8 must be set to an output.

  @Returns
    None.

  @Param
    None.

  @Example
    <code>
    // Set RB8 high (1)
    SCK2OUT_SetHigh();
    </code>

*/
#define SCK2OUT_SetHigh()          (_LATB8 = 1)
/**
  @Summary
    Sets the GPIO pin, RB8, low using LATB8.

  @Description
    Sets the GPIO pin, RB8, low using LATB8.

  @Preconditions
    The RB8 must be set to an output.

  @Returns
    None.

  @Param
    None.

  @Example
    <code>
    // Set RB8 low (0)
    SCK2OUT_SetLow();
    </code>

*/
#define SCK2OUT_SetLow()           (_LATB8 = 0)
/**
  @Summary
    Toggles the GPIO pin, RB8, using LATB8.

  @Description
    Toggles the GPIO pin, RB8, using LATB8.

  @Preconditions
    The RB8 must be set to an output.

  @Returns
    None.

  @Param
    None.

  @Example
    <code>
    // Toggle RB8
    SCK2OUT_Toggle();
    </code>

*/
#define SCK2OUT_Toggle()           (_LATB8 ^= 1)
/**
  @Summary
    Reads the value of the GPIO pin, RB8.

  @Description
    Reads the value of the GPIO pin, RB8.

  @Preconditions
    None.

  @Returns
    None.

  @Param
    None.

  @Example
    <code>
    uint16_t portValue;

    // Read RB8
    postValue = SCK2OUT_GetValue();
    </code>

*/
#define SCK2OUT_GetValue()         _RB8
/**
  @Summary
    Configures the GPIO pin, RB8, as an input.

  @Description
    Configures the GPIO pin, RB8, as an input.

  @Preconditions
    None.

  @Returns
    None.

  @Param
    None.

  @Example
    <code>
    // Sets the RB8 as an input
    SCK2OUT_SetDigitalInput();
    </code>

*/
#define SCK2OUT_SetDigitalInput()  (_TRISB8 = 1)
/**
  @Summary
    Configures the GPIO pin, RB8, as an output.

  @Description
    Configures the GPIO pin, RB8, as an output.

  @Preconditions
    None.

  @Returns
    None.

  @Param
    None.

  @Example
    <code>
    // Sets the RB8 as an output
    SCK2OUT_SetDigitalOutput();
    </code>

*/
#define SCK2OUT_SetDigitalOutput() (_TRISB8 = 0)

/**
    Section: Function Prototypes
*/
/**
  @Summary
    Configures the pin settings of the dsPIC33EP32GP502
    The peripheral pin select, PPS, configuration is also handled by this manager.

  @Description
    This is the generated manager file for the PIC24 / dsPIC33 / PIC32MM MCUs device.  This manager
    configures the pins direction, initial state, analog setting.
    The peripheral pin select, PPS, configuration is also handled by this manager.

  @Preconditions
    None.

  @Returns
    None.

  @Param
    None.

  @Example
    <code>
    void SYSTEM_Initialize(void)
    {
        // Other initializers are called from this function
        PIN_MANAGER_Initialize();
    }
    </code>

*/
void PIN_MANAGER_Initialize (void);



#endif
