zrs5532/mri_demo/(commit log)

2021-02-04 repository created
    [testing_project.kicad_pcb, testing_project.sch]
2021-02-05 local schematic library renamed
2021-02-06 test fron Dan
    [testing_project.sch]
2021-02-09 real circuit board design added
    circuit design under "circuit_board/SensorDemo", project library added under "circuit_board/library"
    [SensorDemo.kicad_pcb, SensorDemo.sch]
2021-02-09 testing project under "circuit_board" is removed.
    [testing_project.kicad_pcb, testing_project.sch]
2021-02-10 updated schematic & footprints
    [SensorDemo.sch]
2021-02-10 relocate the SensorDemo.x project into "firmware" folder
    nothing else has been changed.
2021-02-10 schematic comments made
    minor updates:
    edited schematic library to make some parts look better
    [SensorDemo.sch]
2021-02-11 schematic changes
    [SensorDemo.sch]
2021-02-11 add some comments
    [SensorDemo.sch]
2021-02-11 updated schematic
    [SensorDemo.sch]
2021-02-14 schematic edited
    1. Let's use another REF1930 to bias the sensors. limit current to 15mA (20mA maximum) for safe operation.
    2. FBC filter added to AVDD pin. value FB value needed.
    3. sensor circuit included, with the position of two current limiting resistors.
    4. bypass and decouple caps are added to INA & DAC power lines.
    5. to Daniel: please add crystal circuit to the MCU, and finish the FT232 circuit.
    [SensorDemo.sch]
2021-02-16 minor update
    ft231 breakout board added under reference folder.
    minor update on schematic.
    [SensorDemo.sch, ft231x-breakout-v11.brd, ft231x-breakout-v11.sch]
2021-02-17 updated schematic
    added footprints to everything and minor changes to 6pin
    [SensorDemo.kicad_pcb, SensorDemo.sch, ft231x-breakout-v11.kicad_pcb, ft231x-breakout-v11.sch]
2021-02-18 updates in firmware
    attempted to implement interrupt calibration
2021-02-19 updated schematic
    added footprints & created footprint for connector
    [SensorDemo.sch]
2021-02-22 update schematic
    pcb parts in place. need to connect traces
    [SensorDemo.kicad_pcb]
2021-02-22 minor change on schematic
    please add pads to the 6 pin connector.
    [SensorDemo.sch]
2021-02-23 updated schematic
    -spaced parts
    -filled ground layer
    -added vias
    [SensorDemo.kicad_pcb]
2021-02-23 symbol and pcb footprint updated
    Added test points to replace the sensors.
    TC2030 part modified.
    the button needs modification.
    TG connector:
    https://www.tag-connect.com/product/tc2030-alt-nl-no-legs-cable-for-use-with-altera-usb-blaster
    [SensorDemo.kicad_pcb, SensorDemo.sch]
2021-02-24 updated schematic
    -fixed footprints
    -spread parts
    -connected some traces
    - found FB (1kOhm, 1A)
    [SensorDemo.kicad_pcb, SensorDemo.sch]
2021-02-25 update pcb
    -connected traces
    [SensorDemo.kicad_pcb]
2021-02-25 PCB edited
    [SensorDemo.kicad_pcb, SensorDemo.sch]
2021-02-26 completed ProgramBoard
    [ProgramBoard.kicad_pcb, ProgramBoard.sch]
2021-02-27 SensorDemo board updated
    re-positioned all components and routed pcb.
    [SensorDemo.kicad_pcb, SensorDemo.sch, SensorDemo_backup_1.kicad_pcb]
2021-02-27 key needs revise
    check the button's footprint.
    [SensorDemo.kicad_pcb]
2021-02-28 examined the program board
    try to switch to 10 pin tag cable to combine the programmer, UART, and power.
    [ProgramBoard.kicad_pcb, ProgramBoard.sch, SensorDemo.kicad_pcb]
2021-03-01 SensorDemo and Program board modified
    1. SensorDemo board minor adjustment, 3D models added.
    2. the TC2050 cable is added and routed on programmer board.
    3. 3D models are added into the library.
    [ProgramBoard.kicad_pcb, ProgramBoard.sch, SensorDemo.kicad_pcb]
2021-03-05 firmware update
    polling calibration
2021-03-05 updated button footprint
    [SensorDemo.kicad_pcb]
2021-03-09 reset key modified
    [SensorDemo.kicad_pcb, SensorDemo.sch]
2021-03-09 updated SensoDemo and ProgramBoard
    INA126 is replaced by INA333.
    TC2050-IDC-NL cable will be used for powering and programming.
    both boards should be done.
    [ProgramBoard.kicad_pcb, ProgramBoard.sch, SensorDemo.kicad_pcb, SensorDemo.sch]
2021-03-10 updated schematic
    -fixed programming board 5v
    [ProgramBoard.kicad_pcb, ProgramBoard.sch]
2021-03-10 testing pins added
    updated PCB design:
    added testing pins on the SensorDemo.
    ProgramBoard modified GND connections.
    [ProgramBoard.kicad_pcb, ProgramBoard.sch, SensorDemo.kicad_pcb]
2021-03-10 modified according to Doug
    on SensorDemo, fiducial marks are added, via size changed to .25mm and .55mm, decreased solder mask gap between pins on MSOP8 package.
    the minimum JLC can take between pins is .2mm for green mask.
    [ProgramBoard.kicad_pcb, SensorDemo.kicad_pcb]
2021-03-12 PCB fabrication file generated
    the PCBs are sent to JLC for fabrication, gerber files created.
    [ProgramBoard-B_Cu.gbr, ProgramBoard-B_Mask.gbr, ProgramBoard-B_SilkS.gbr, ProgramBoard-Edge_Cuts.gbr, ProgramBoard-F_Cu.gbr, ProgramBoard-F_Mask.gbr, ProgramBoard-F_SilkS.gbr, ProgramBoard.drl]
2021-03-13 firmware change
    - cleaned up code
    - changed calibration structure
2021-03-16 updated firmware
    -improved accuracy of calibration
2021-03-16 Revert "Merge branch 'master' of https://github.com/zrs5532/mri_demo"
    This reverts commit b0c8028f714b16f114d60085c0a86ac2043fc740, reversing
    changes made to 0fccd9f34ae5c363ed48057d6b873a7540cc24aa.
    [ProgramBoard-B_Cu.gbr, ProgramBoard-B_Mask.gbr, ProgramBoard-B_SilkS.gbr, ProgramBoard-Edge_Cuts.gbr, ProgramBoard-F_Cu.gbr, ProgramBoard-F_Mask.gbr, ProgramBoard-F_SilkS.gbr, ProgramBoard.drl]
2021-03-16 Revert "Revert "Merge branch 'master' of https://github.com/zrs5532/mri_demo""
    This reverts commit c7bcd66b67d9c03c78e75f611b5453059c538dec.
    [ProgramBoard-B_Cu.gbr, ProgramBoard-B_Mask.gbr, ProgramBoard-B_SilkS.gbr, ProgramBoard-Edge_Cuts.gbr, ProgramBoard-F_Cu.gbr, ProgramBoard-F_Mask.gbr, ProgramBoard-F_SilkS.gbr, ProgramBoard.drl]
2021-03-17 added BOM
    [BOM.xlsx]
2021-03-17 Updated BOM
    BOM is edited so ready to purchase the part. Right now, LTC1658 is not available anywhere (mouser/digikey), so LTC1659 (12-bit) and LTC1655L (16-bit) are ordered instead.
    parts marked as "stunts" are for practice purpose.
    [BOM.xlsx, ProgramBoard.sch]
2021-04-06 calibration change
2021-04-07 calibration fix
    -finally works
    -can make bit faster
    -clean up code (debug)
    [main.c]
2021-04-08 Update Firmware
    -Added Comments
    -Made Calibration faster
2021-08-11 updated fiducial marks
    [SensorDemo.kicad_pcb]
